avatarlinken/main/hardware/README.md

# 硬件设计

本工程的硬件原理图与 PCB 已在 **立创开源硬件平台** 上更新发布。

## 开源链接

🔗 **[多路倍频 - 立创开源硬件](https://oshwhub.com/tudou12312/duo-lu-bei-pin)**

点击上方链接可查看/下载：
- 原理图
- PCB 设计
- 元件清单
- 最新版本硬件资料

如有更新，将在该链接中同步发布。
