avatarlinken/main/hardware/SCH_Schematic1_2026-03-14.pdf

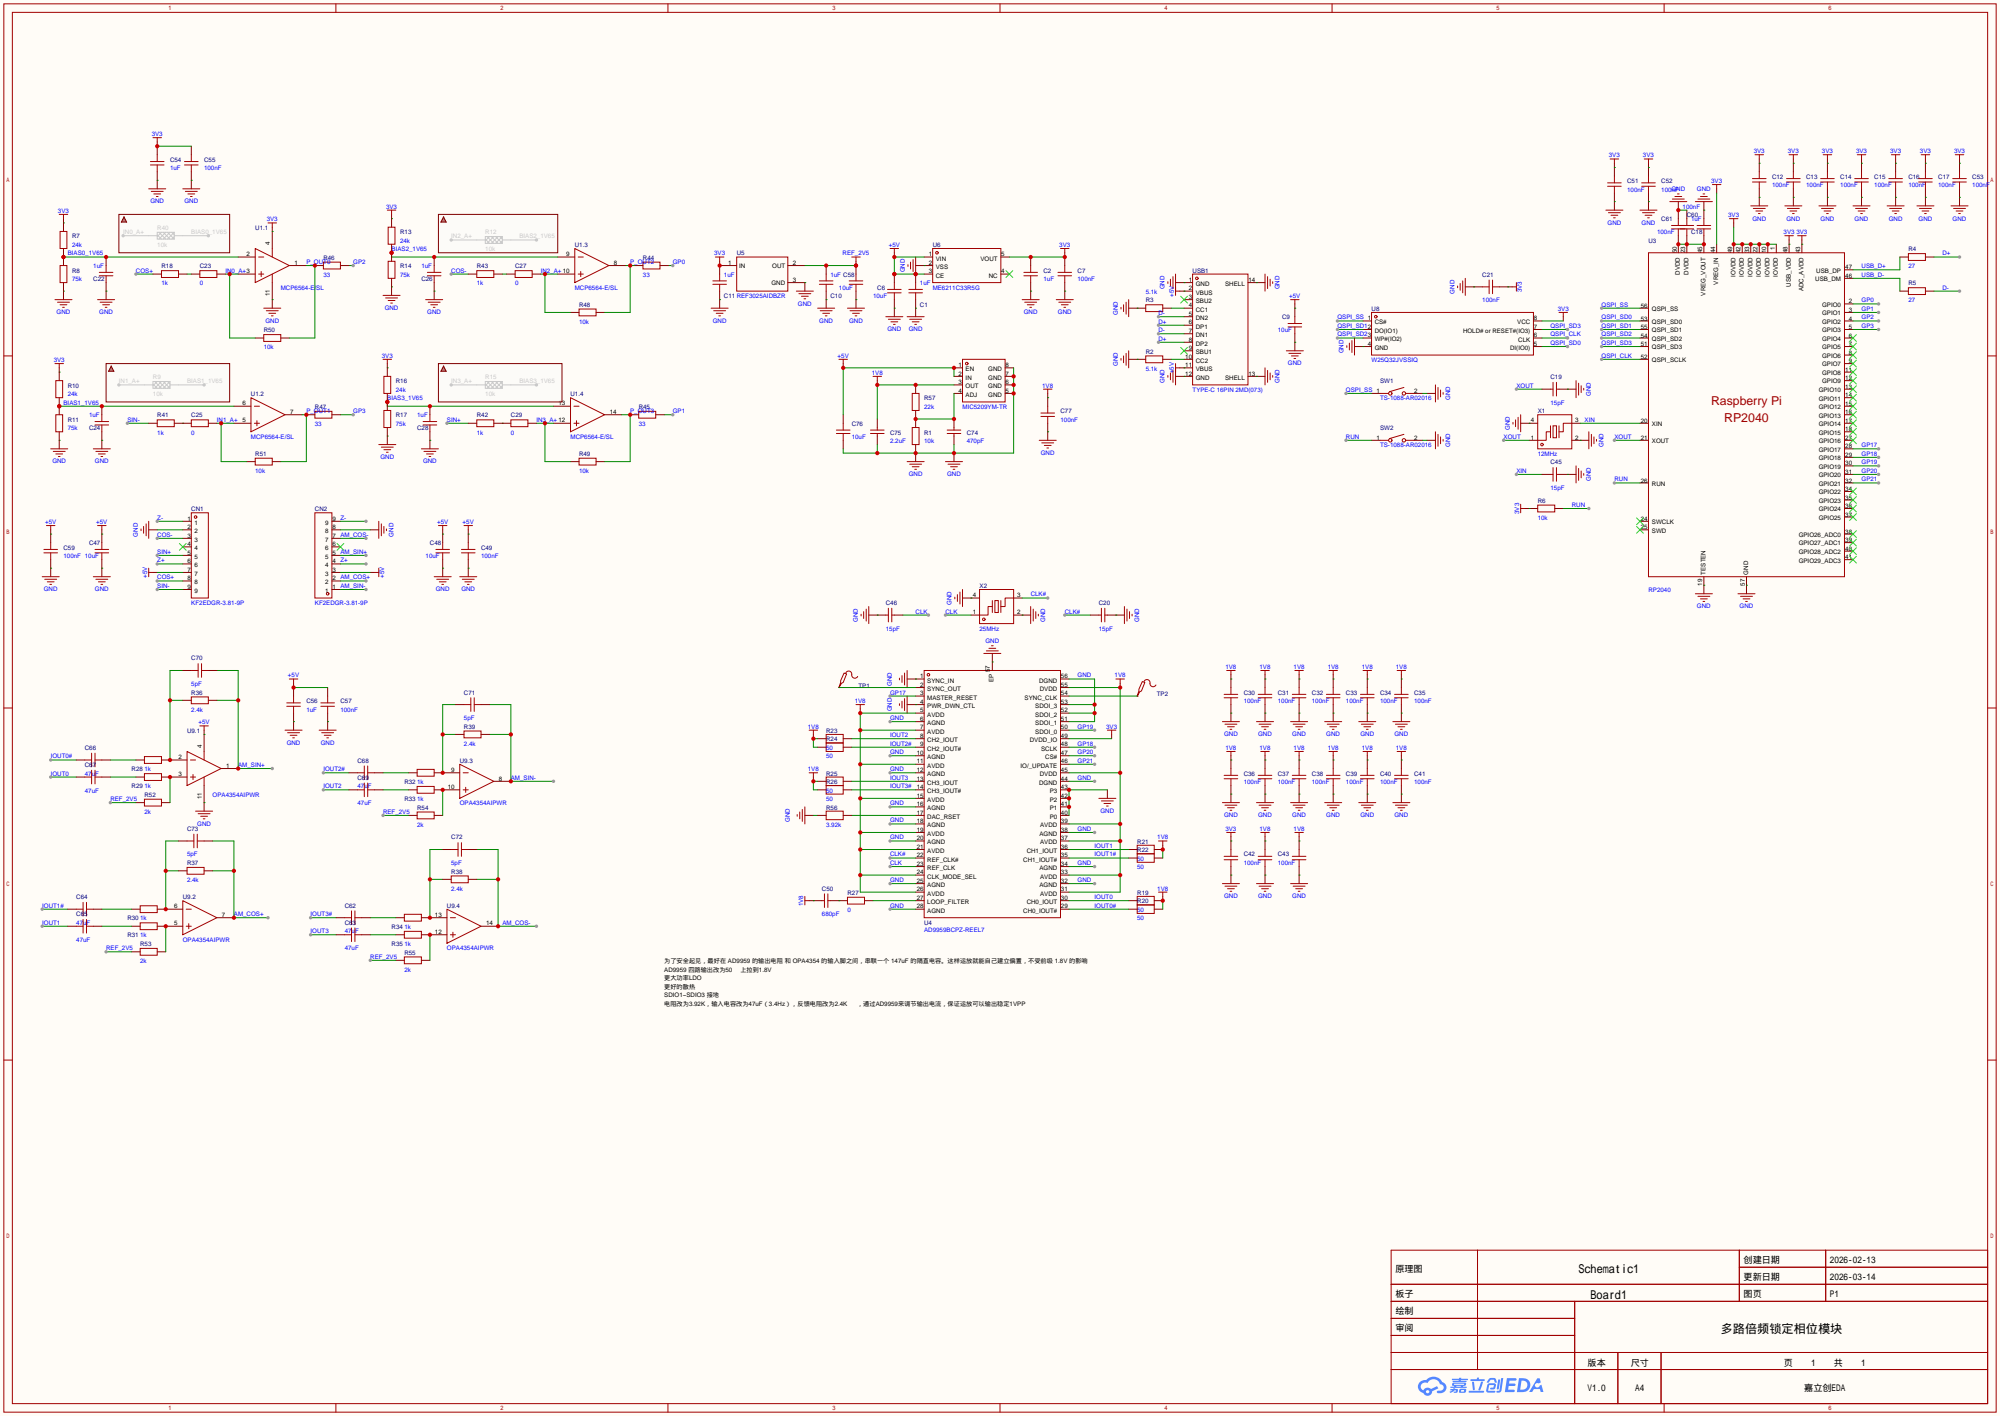
[picture p5: page 1]

为了安全起见，最好在 AD9959 的输出电阻 和 OPA4354 的输入脚之间，串联一个 147uF 的隔直电容。这样运放就能自己建立偏置，不受前级 1.8V 的影响
AD9959 四路输出改为50 上拉到1.8V
更大功率LDO
更好的散热
SDIO1~SDIO3 接地
电阻改为3.92K，输入电容改为47uF（3.4Hz），反馈电阻改为2.4K ，通过AD9959来调节输出电流，保证运放可以输出稳定1VPP

原理图 | Schematic1 | 创建日期 | 2026-02-13

更新日期 | 2026-03-14

板子 | Board1 | 图页 | P1

绘制 | | 多路倍频锁定相位模块
审阅

V1.0 | A4 | 嘉立创EDA
