avatarlinken/main/(commit log)

2026-02-21 新增硬件设计链接
2026-02-21 Refactor frequency measurement logic and update EMA parameters for improved responsiveness and stability. Adjusted deadzone and two-sample confirmation thresholds for better accuracy.
    [main.ino]
2026-02-28 硬件原理图和PCB更新
2026-03-14 添加使用文档
    Made-with: Cursor
2026-03-14 修改电路，增加使用说明
